DMD-Engineering/Rantoge-Clock/Docs/Schematic.jpg

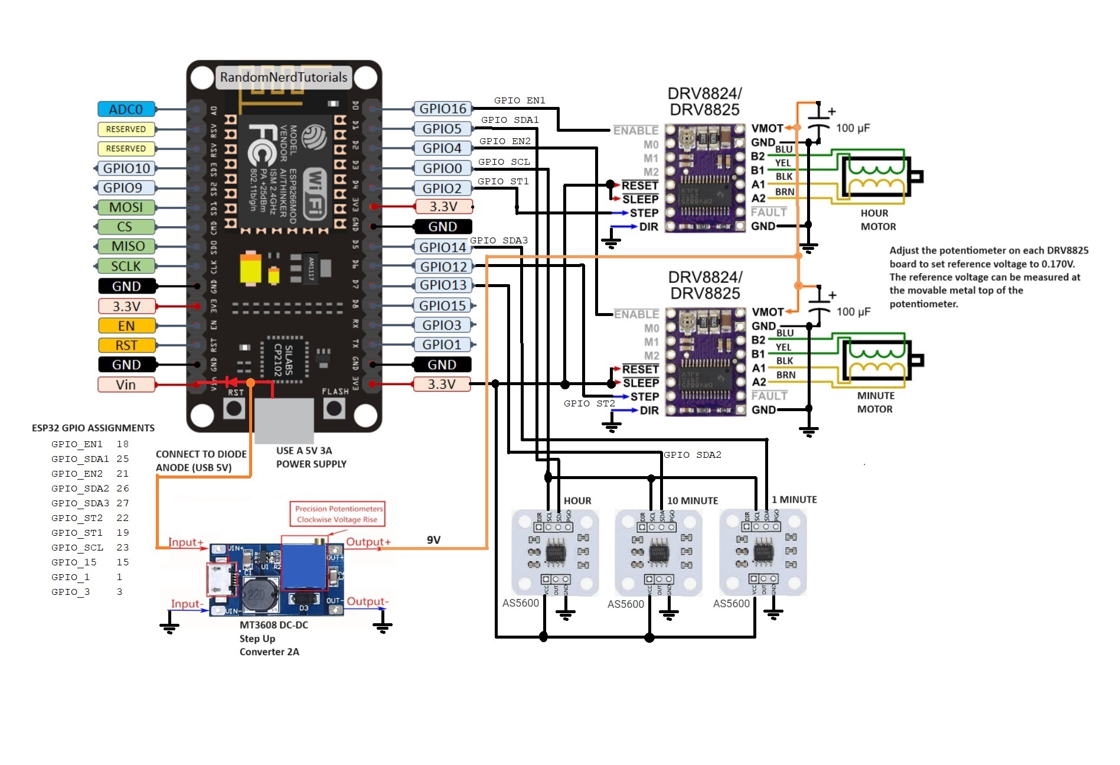
Docs/Schematic.jpg
