DMD-Engineering/Rantoge-Clock/Docs/IMG_2825.jpeg

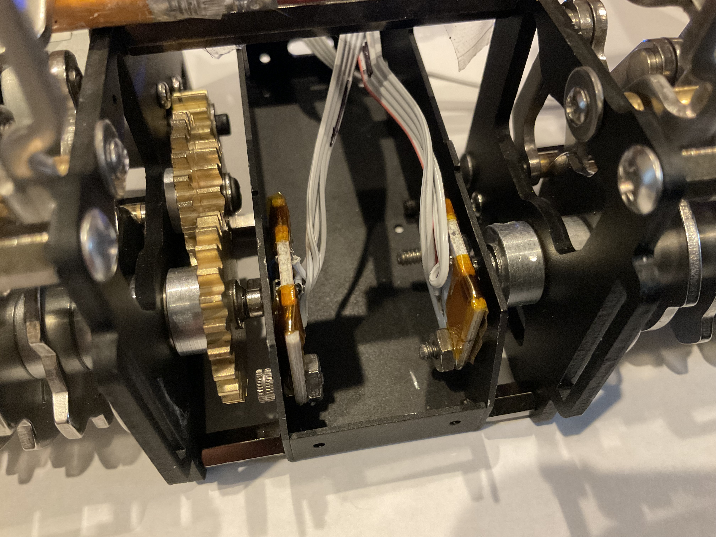
Docs/IMG_2825.jpeg
