DMD-Engineering/Rantoge-Clock/Docs/ComponentsSourcing.txt

5Pcs Boost Module MT3608 DC-DC Step Up Converter 2A Boost Regulator Voltage Converter Board Type C Power Supply Module Adjustable Voltage Regulator Input Voltage 2V-24V to 5V-28V Voltage Module
https://www.amazon.com/Module-Converter-Regulator-Voltage-Adjustable/dp/B0C69CKRWN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

AS5600 Magnetic Encoder 12bit high Precision Magnetic Induction Angle Measurement Sensor Module 3.3V (5PCS)
https://www.amazon.com/Teyleten-Robot-Precision-Induction-Measurement/dp/B09LMB3PTZ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

NodeMCU V3 ESP8266 ESP-12E CH340G WIFI USB Development Board Expansion Board
https://www.ebay.com/itm/354644746229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
DIGISHUO 2Pcs ESP8266 NodeMCU CH340 ESP-12E Development Board Open Source Serial Module Works Great for Arduino IDE/Micropython (2Pcs ESP8266 NodeMCU CH340)
https://www.amazon.com/DIGISHUO-ESP8266-NodeMCU-Development-Micropython/dp/B0966MLWV1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

3D Printer Parts DRV8825 Stepper Motor Driver Module with Heat Sink for Ramps 1.4 StepStick A4988 (5pcs)
https://www.amazon.com/Teyleten-Robot-Printer-DRV8825-StepStick/dp/B0CP92T4QR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
