DMD-Engineering/Rantoge-Clock/Docs/Schematic.pdf

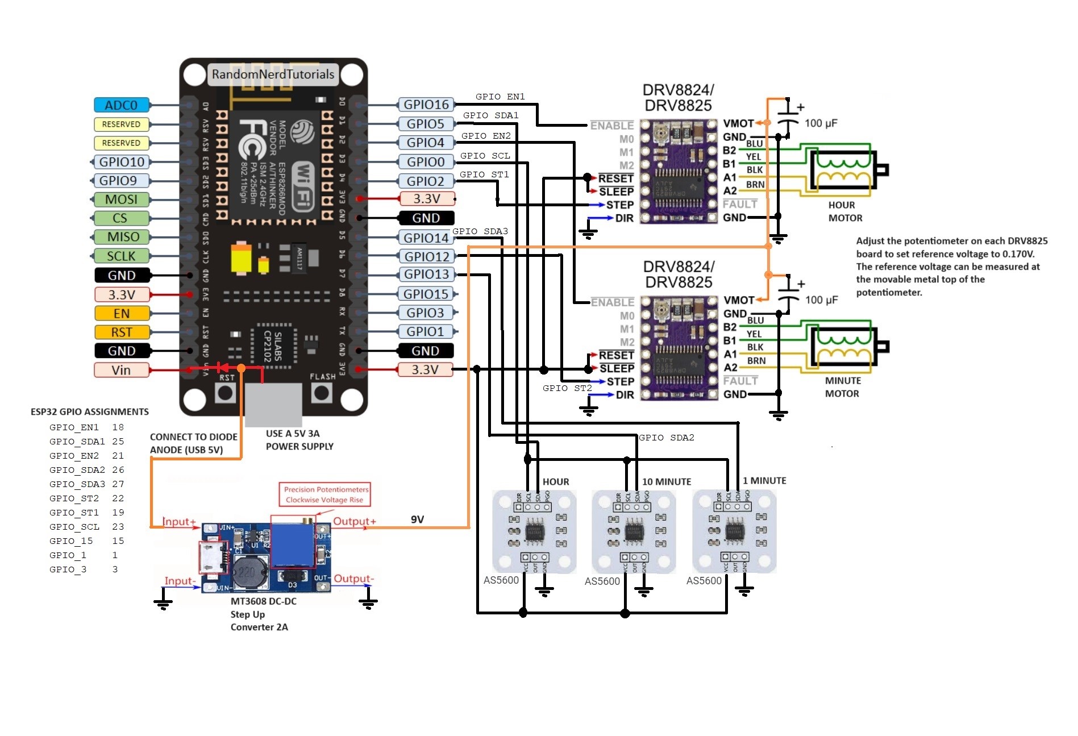
[picture p3: figure]
