DMD-Engineering/Rantoge-Clock/Docs/IMG_2826.jpeg

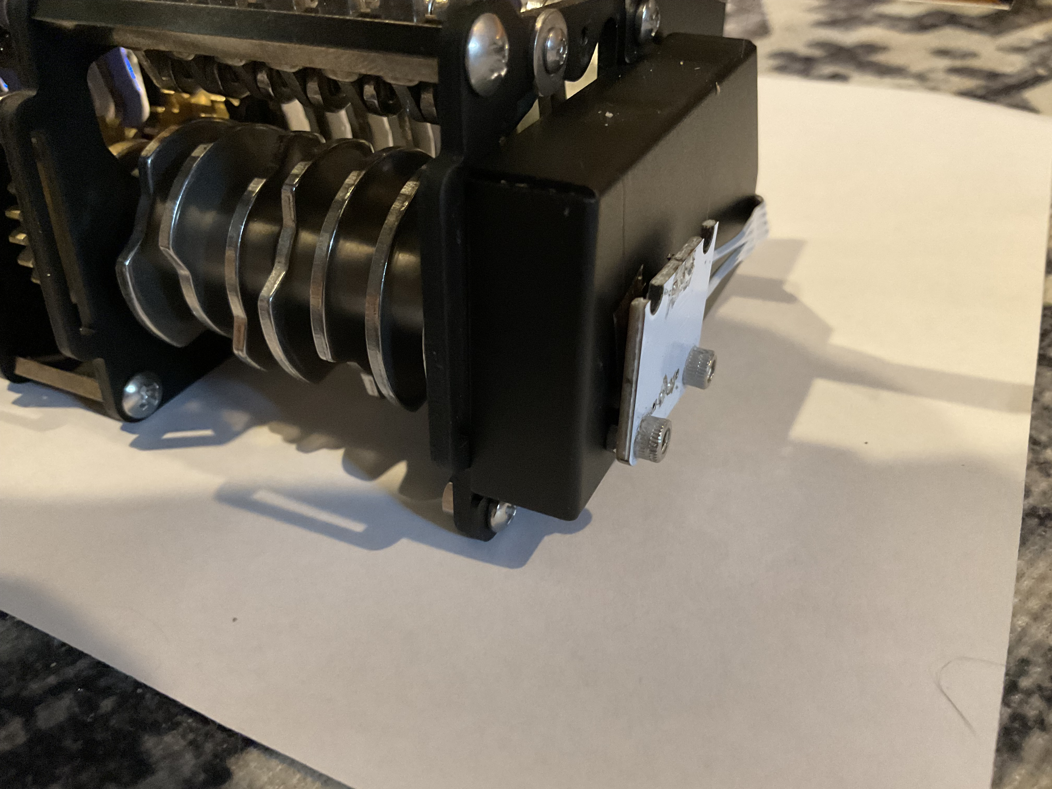
Docs/IMG_2826.jpeg
