DMD-Engineering/Rantoge-Clock/Docs/IMG_2831.jpeg

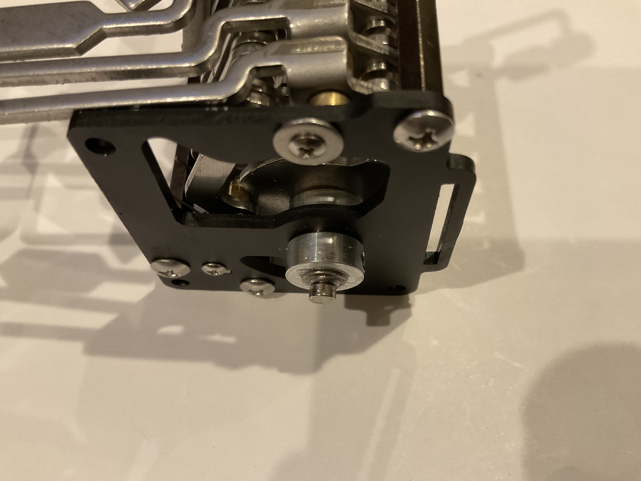
Docs/IMG_2831.jpeg
