DMD-Engineering/Rantoge-Clock/Docs/IMG_2832.jpeg

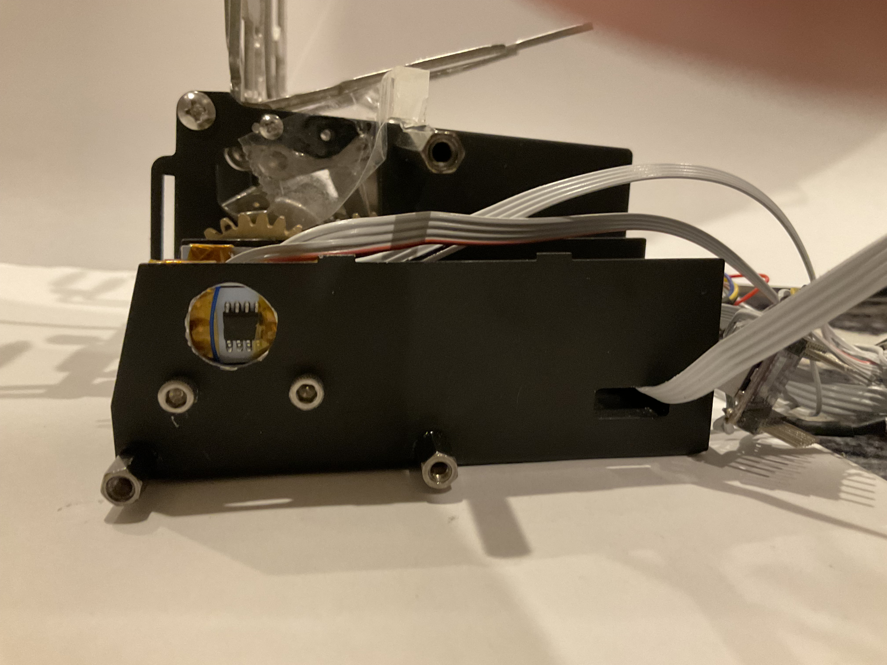
Docs/IMG_2832.jpeg
