DMD-Engineering/Rantoge-Clock/Docs/IMG_2833.jpeg

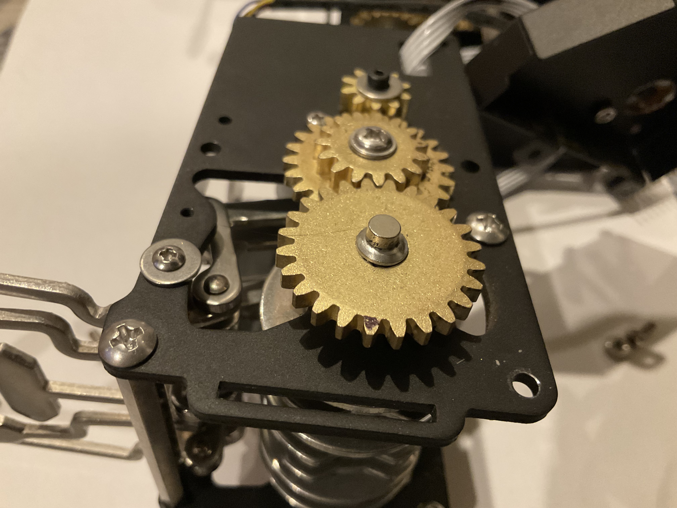
Docs/IMG_2833.jpeg
