DMD-Engineering/Rantoge-Clock/Docs/IMG_2834.jpeg

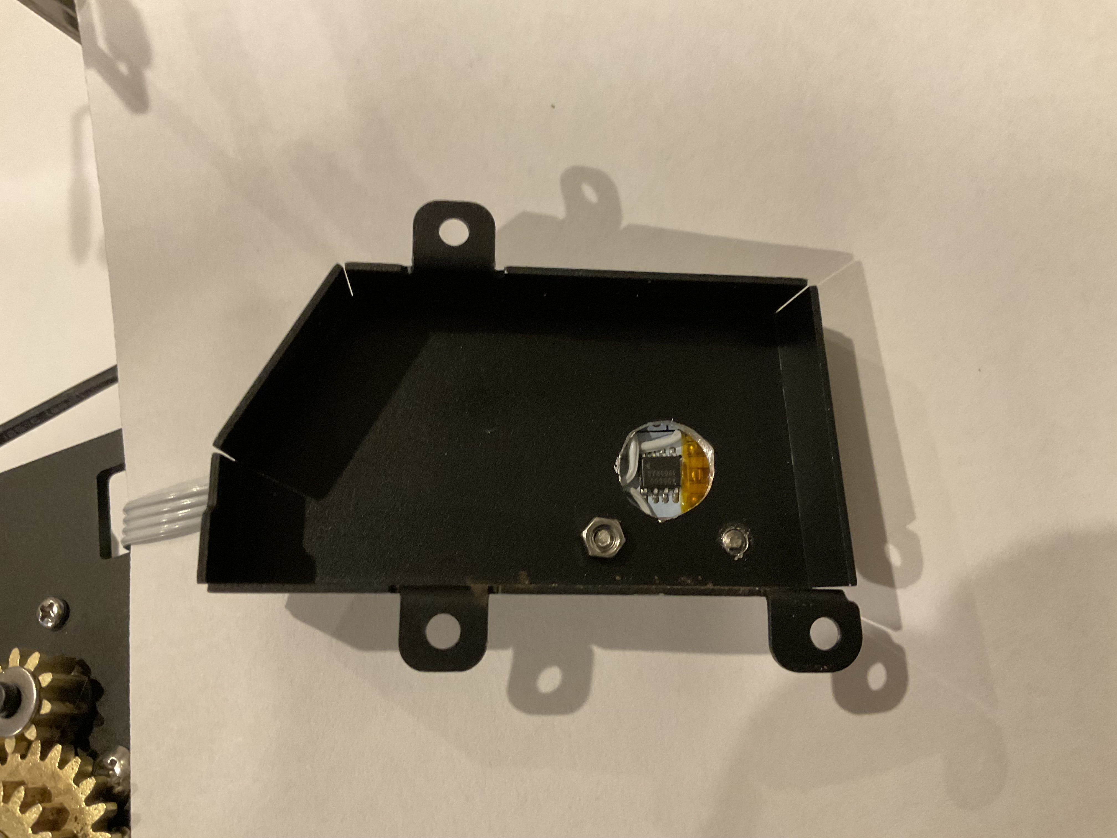
Docs/IMG_2834.jpeg
