DMD-Engineering/Rantoge-Clock/SPIFFSEditor_DMD.cpp

#include "SPIFFSEditor_DMD.h"
#include <FS.h>
#ifdef ESP32
 #include <SPIFFS.h>
#else
 #include <FS.h>
#endif

//File: edit.htm.gz, Size: 4151
#define edit_htm_gz_len 4151
const uint8_t edit_htm_gz[] PROGMEM = {
 0x1F, 0x8B, 0x08, 0x08, 0xB8, 0x94, 0xB1, 0x59, 0x00, 0x03, 0x65, 0x64, 0x69, 0x74, 0x2E, 0x68,
 0x74, 0x6D, 0x00, 0xB5, 0x3A, 0x0B, 0x7B, 0xDA, 0xB8, 0xB2, 0x7F, 0xC5, 0x71, 0xCF, 0x66, 0xED,
 0x83, 0x31, 0x90, 0xA4, 0xD9, 0xD6, 0xC4, 0xC9, 0x42, 0x92, 0x36, 0x6D, 0xF3, 0x6A, 0x80, 0xB6,
 0x69, 0x4F, 0xEE, 0x7E, 0xC2, 0x16, 0xA0, 0xC6, 0x96, 0x5D, 0x5B, 0x0E, 0x49, 0x59, 0xFE, 0xFB,
 0x9D, 0x91, 0x6C, 0xB0, 0x09, 0x69, 0x77, 0xCF, 0xBD, 0xBB, 0xDD, 0x2D, 0x92, 0x46, 0x33, 0x9A,
 0x19, 0xCD, 0x53, 0xDE, 0xBD, 0x8D, 0xA3, 0x8B, 0xC3, 0xFE, 0xF5, 0xE5, 0xB1, 0x36, 0x11, 0x61,
 0xB0, 0xBF, 0x87, 0x7F, 0x6B, 0x01, 0xE1, 0x63, 0x97, 0xF2, 0xFD, 0x3D, 0xC1, 0x44, 0x40, 0xF7,
 0x8F, 0x7B, 0x97, 0xDA, 0xB1, 0xCF, 0x44, 0x94, 0xEC, 0x35, 0xD4, 0xCA, 0x5E, 0x2A, 0x1E, 0x02,
 0xAA, 0x85, 0xD4, 0x67, 0xC4, 0x4D, 0xBD, 0x84, 0xC2, 0x66, 0xDB, 0x0B, 0x67, 0xDF, 0xEB, 0x8C,
 0xFB, 0xF4, 0xDE, 0xD9, 0x6E, 0x36, 0xDB, 0x71, 0x94, 0x32, 0xC1, 0x22, 0xEE, 0x90, 0x61, 0x1A,
 0x05, 0x99, 0xA0, 0xED, 0x80, 0x8E, 0x84, 0xF3, 0x3C, 0xBE, 0x6F, 0x0F, 0xA3, 0xC4, 0xA7, 0x89,
 0xD3, 0x8A, 0xEF, 0x35, 0x00, 0x31, 0x5F, 0x7B, 0xB6, 0xB3, 0xB3, 0xD3, 0x1E, 0x12, 0xEF, 0x76,
 0x9C, 0x44, 0x19, 0xF7, 0xEB, 0x5E, 0x14, 0x44, 0x89, 0xF3, 0x6C, 0xF4, 0x1C, 0xFF, 0xB4, 0x7D,
 0x96, 0xC6, 0x01, 0x79, 0x70, 0x78, 0xC4, 0x29, 0xE0, 0xDE, 0xD7, 0xD3, 0x09, 0xF1, 0xA3, 0xA9,
 0xD3, 0xD4, 0x9A, 0x5A, 0xAB, 0x09, 0x44, 0x92, 0xF1, 0x90, 0x18, 0x4D, 0x0B, 0xFF, 0xD8, 0x3B,
 0x66, 0x7B, 0x14, 0x71, 0x51, 0x4F, 0xD9, 0x77, 0xEA, 0xB4, 0xB6, 0xE0, 0x34, 0x39, 0x1D, 0x91,
 0x90, 0x05, 0x0F, 0x4E, 0x4A, 0x78, 0x5A, 0x4F, 0x69, 0xC2, 0x46, 0x6A, 0x79, 0x4A, 0xD9, 0x78,
 0x22, 0x9C, 0xDF, 0x9A, 0xCD, 0x39, 0xF0, 0xAF, 0x65, 0xC1, 0x2C, 0x60, 0x29, 0x20, 0xA3, 0x78,
 0xEA, 0x3C, 0x11, 0xC5, 0x4E, 0x53, 0xB1, 0xDE, 0x6C, 0x87, 0x24, 0x19, 0x33, 0x0E, 0x83, 0x98,
 0xF8, 0x3E, 0xE3, 0x63, 0x47, 0xA1, 0x05, 0x6C, 0xB6, 0x90, 0x36, 0xA1, 0x01, 0x11, 0xEC, 0x8E,
 0xB6, 0x43, 0xC6, 0xEB, 0x53, 0xE6, 0x8B, 0x89, 0xB3, 0x0B, 0x3C, 0xB6, 0xBD, 0x2C, 0x49, 0x41,
 0xA6, 0x38, 0x62, 0x5C, 0xD0, 0x44, 0xA2, 0xA5, 0x31, 0xE1, 0xB3, 0x5C, 0x54, 0x54, 0x40, 0x21,
 0x27, 0xE3, 0x01, 0xE3, 0xB4, 0x3E, 0x0C, 0x22, 0xEF, 0x76, 0x71, 0xD2, 0x6E, 0x7C, 0x9F, 0x9F,
 0xE5, 0x4C, 0xA2, 0x3B, 0x9A, 0xCC, 0x96, 0xEA, 0x92, 0xD8, 0x15, 0x60, 0x85, 0x34, 0xA5, 0x74,
 0x6E, 0x8B, 0xBB, 0x0C, 0xA0, 0x96, 0xFC, 0x05, 0x29, 0x17, 0xFC, 0x2F, 0x45, 0x5A, 0x11, 0x5C,
 0xA1, 0x30, 0x1E, 0x67, 0x62, 0xF6, 0xF8, 0x2A, 0xA3, 0x98, 0x78, 0x4C, 0x3C, 0xA0, 0xFC, 0xB0,
 0x6D, 0x86, 0xBA, 0x04, 0xAC, 0x24, 0x24, 0x81, 0x86, 0x3A, 0xD7, 0x3E, 0xD0, 0xC4, 0x27, 0x9C,
 0x58, 0x9D, 0x84, 0x91, 0xC0, 0xEA, 0x2D, 0xB5, 0x5E, 0x0F, 0xA3, 0xEF, 0xF5, 0x0C, 0xC6, 0x30,
 0x0F, 0xA8, 0x27, 0x94, 0x92, 0xE1, 0x1E, 0x86, 0xB7, 0x4C, 0x3C, 0x06, 0x3C, 0x5A, 0x28, 0xA9,
 0x4B, 0x2A, 0x69, 0xA2, 0x2E, 0xB0, 0x25, 0xD5, 0x83, 0x1C, 0x4B, 0xC9, 0x95, 0x50, 0xF5, 0x61,
 0x24, 0x44, 0x14, 0x4A, 0x93, 0x5B, 0x08, 0xAC, 0x49, 0xAB, 0x79, 0xF1, 0xE8, 0x46, 0xD6, 0x6B,
 0xBF, 0x44, 0xBE, 0x0D, 0x7A, 0x15, 0xCC, 0x23, 0x41, 0x9D, 0x04, 0x6C, 0xCC, 0x9D, 0x90, 0xF9,
 0x7E, 0x40, 0x4B, 0x56, 0xEB, 0x64, 0x49, 0x60, 0xF8, 0x44, 0x10, 0x87, 0x85, 0x64, 0x4C, 0x1B,
 0x31, 0x1F, 0x03, 0x34, 0xA5, 0xBB, 0x3B, 0x16, 0xFB, 0xD0, 0xBD, 0xB8, 0x9A, 0x36, 0xDF, 0xBD,
 0x1E, 0x47, 0x1D, 0xF8, 0xE7, 0xBC, 0x37, 0x98, 0x1C, 0x0F, 0xC6, 0x30, 0xEA, 0xE2, 0xB4, 0xF3,
 0xFE, 0xB0, 0xF3, 0x1E, 0x7E, 0x0E, 0x5B, 0xB5, 0xAF, 0xA3, 0x6F, 0xB8, 0xD0, 0x7D, 0xED, 0x77,
 0xFB, 0x83, 0xE3, 0x4E, 0xE7, 0x5D, 0xE3, 0xCD, 0xF9, 0xF4, 0xE3, 0xBB, 0x5D, 0x04, 0x77, 0x83,
 0xE6, 0xD5, 0x87, 0x49, 0x73, 0xB0, 0xF5, 0x32, 0xF4, 0x4F, 0xFC, 0x89, 0x17, 0x0E, 0x3A, 0xEF,
 0x3F, 0x5E, 0xDD, 0x5D, 0x87, 0x83, 0x71, 0xEF, 0x63, 0x6B, 0xF2, 0x79, 0xEB, 0x43, 0xEF, 0xF3,
 0xC7, 0x57, 0xB7, 0xF4, 0xD3, 0xC9, 0xDB, 0xCF, 0xFD, 0x29, 0x20, 0x1C, 0x45, 0xBD, 0xC1, 0x55,
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
};

#define SPIFFS_MAXLENGTH_FILEPATH 32
const char *excludeListFile_DMD = "/.exclude.files";

typedef struct ExcludeListS {
    char *item;
    ExcludeListS *next;
} ExcludeList;

static ExcludeList *excludes = NULL;

static bool matchWild(const char *pattern, const char *testee) {
  const char *nxPat = NULL, *nxTst = NULL;

  while (*testee) {
    if (( *pattern == '?' ) || (*pattern == *testee)){
      pattern++;testee++;
      continue;
    }
    if (*pattern=='*'){
      nxPat=pattern++; nxTst=testee;
      continue;
    }
    if (nxPat){ 
      pattern = nxPat+1; testee=++nxTst;
      continue;
    }
    return false;
  }
  while (*pattern=='*'){pattern++;}  
  return (*pattern == 0);
}

static bool addExclude(const char *item){
    size_t len = strlen(item);
    if(!len){
        return false;
    }
    ExcludeList *e = (ExcludeList *)malloc(sizeof(ExcludeList));
    if(!e){
        return false;
    }
    e->item = (char *)malloc(len+1);
    if(!e->item){
        free(e);
        return false;
    }
    memcpy(e->item, item, len+1);
    e->next = excludes;
    excludes = e;
    return true;
}

static void loadExcludeList(fs::FS &_fs, const char *filename){
    static char linebuf[SPIFFS_MAXLENGTH_FILEPATH];
    fs::File excludeFile=_fs.open(filename, "r");
    if(!excludeFile){
        //addExclude("/*.js.gz");
        return;
    }
#ifdef ESP32
    if(excludeFile.isDirectory()){
      excludeFile.close();
      return;
    }
#endif
    if (excludeFile.size() > 0){
      uint8_t idx;
      bool isOverflowed = false;
      while (excludeFile.available()){
        linebuf[0] = '\0';
        idx = 0;
        int lastChar;
        do {
          lastChar = excludeFile.read();
          if(lastChar != '\r'){
            linebuf[idx++] = (char) lastChar;
          }
        } while ((lastChar >= 0) && (lastChar != '\n') && (idx < SPIFFS_MAXLENGTH_FILEPATH));

        if(isOverflowed){
          isOverflowed = (lastChar != '\n');
          continue;
        }
        isOverflowed = (idx >= SPIFFS_MAXLENGTH_FILEPATH);
        linebuf[idx-1] = '\0';
        if(!addExclude(linebuf)){
            excludeFile.close();
            return;
        }
      }
    }
    excludeFile.close();
}

static bool isExcluded(fs::FS &_fs, const char *filename) {
  if(excludes == NULL){
      loadExcludeList(_fs, excludeListFile_DMD);
  }
  ExcludeList *e = excludes;
  while(e){
    if (matchWild(e->item, filename)){
      return true;
    }
    e = e->next;
  }
  return false;
}

// WEB HANDLER IMPLEMENTATION

#ifdef ESP32
SPIFFSEditor_DMD::SPIFFSEditor_DMD(const fs::FS& fs, const String& username, const String& password)
#else
SPIFFSEditor_DMD::SPIFFSEditor_DMD(const String& username, const String& password, const fs::FS& fs)
#endif
:_fs(fs)
,_username(username)
,_password(password)
,_authenticated(false)
,_startTime(0)
{}

bool SPIFFSEditor_DMD::canHandle(AsyncWebServerRequest *request){
  if(request->url().equalsIgnoreCase("/edit")){
    if(request->method() == HTTP_GET){
      if(request->hasParam("list"))
        return true;
      if(request->hasParam("edit")){
        request->_tempFile = _fs.open(request->arg("edit"), "r");
        if(!request->_tempFile){
          return false;
        }
#ifdef ESP32
        if(request->_tempFile.isDirectory()){
          request->_tempFile.close();
          return false;
        }
#endif
      }
      if(request->hasParam("download")){
        request->_tempFile = _fs.open(request->arg("download"), "r");
        if(!request->_tempFile){
          return false;
        }
#ifdef ESP32
        if(request->_tempFile.isDirectory()){
          request->_tempFile.close();
          return false;
        }
#endif
      }
      request->addInterestingHeader("If-Modified-Since");
      return true;
    }
    else if(request->method() == HTTP_POST)
      return true;
    else if(request->method() == HTTP_DELETE)
      return true;
    else if(request->method() == HTTP_PUT)
      return true;

  }
  return false;
}


void SPIFFSEditor_DMD::handleRequest(AsyncWebServerRequest *request){
  if(_username.length() && _password.length() && !request->authenticate(_username.c_str(), _password.c_str()))
    return request->requestAuthentication();

  if(request->method() == HTTP_GET){
    if(request->hasParam("list")){
      String path = request->getParam("list")->value();
#ifdef ESP32
      File dir = _fs.open(path);
#else
      Dir dir = _fs.openDir(path);
#endif
      path = String();
      String output = "[";
#ifdef ESP32
      File entry = dir.openNextFile();
      while(entry){
#else
      while(dir.next()){
        fs::File entry = dir.openFile("r");
#endif
        if (isExcluded(_fs, entry.name())) {
#ifdef ESP32
            entry = dir.openNextFile();
#endif
            continue;
        }
        if (output != "[") output += ',';
        output += "{\"type\":\"";
        output += "file";
#ifdef ESP32
		//DMD ESP32 +++
        output += "\",\"name\":\"/"; //DMD: To fix no slash before file name
		//DMD ESP32 +++
#else
		//DMD ESP8266 +++
        output += "\",\"name\":\"";  //DMD To fix extra slash before file name
		//DMD ESP8266 +++
#endif
        output += String(entry.name());
        output += "\",\"size\":";
        output += String(entry.size());
        output += "}";
#ifdef ESP32
        entry = dir.openNextFile();
#else
        entry.close();
#endif
      }
#ifdef ESP32
      dir.close();
#endif
      output += "]";
      request->send(200, "application/json", output);
      output = String();
    }
    else if(request->hasParam("edit") || request->hasParam("download")){
      request->send(request->_tempFile, request->_tempFile.name(), String(), request->hasParam("download"));
    }
    else {
      const char * buildTime = __DATE__ " " __TIME__ " GMT";
      if (request->header("If-Modified-Since").equals(buildTime)) {
        request->send(304);
      } else {
        AsyncWebServerResponse *response = request->beginResponse_P(200, "text/html", edit_htm_gz, edit_htm_gz_len);
        response->addHeader("Content-Encoding", "gzip");
        response->addHeader("Last-Modified", buildTime);
        request->send(response);
      }
    }
  } else if(request->method() == HTTP_DELETE){
    if(request->hasParam("path", true)){
        _fs.remove(request->getParam("path", true)->value());
      request->send(200, "", "DELETE: "+request->getParam("path", true)->value());
    } else
      request->send(404);
  } else if(request->method() == HTTP_POST){
    if(request->hasParam("data", true, true) && _fs.exists(request->getParam("data", true, true)->value()))
      request->send(200, "", "UPLOADED: "+request->getParam("data", true, true)->value());
    else
      request->send(500);
  } else if(request->method() == HTTP_PUT){
    if(request->hasParam("path", true)){
      String filename = request->getParam("path", true)->value();
      if(_fs.exists(filename)){
        request->send(200);
      } else {
        fs::File f = _fs.open(filename, "w");
        if(f){
          f.write((uint8_t)0x00);
          f.close();
          request->send(200, "", "CREATE: "+filename);
        } else {
          request->send(500);
        }
      }
    } else
      request->send(400);
  }
}

void SPIFFSEditor_DMD::handleUpload(AsyncWebServerRequest *request, const String& filename, size_t index, uint8_t *data, size_t len, bool final){
  if(!index){
    if(!_username.length() || request->authenticate(_username.c_str(),_password.c_str())){
      _authenticated = true;
      request->_tempFile = _fs.open(filename, "w");
      _startTime = millis();
    }
  }
  if(_authenticated && request->_tempFile){
    if(len){
      request->_tempFile.write(data,len);
    }
    if(final){
      request->_tempFile.close();
    }
  }
}
